c4deszes/bike-front-light/sw/README.md

# Front light software

## Open issues

- ILD8150 Open/Short circuit detection and reporting
- TLD509x control and monitoring
- Temperature monitoring and derating

## Deferred tasks

- Bootloader (depends on SAMC21 support in the Bootloader and HAL library)
- Externally configurable product parameters (depends on diagnostic protocol extension)
