c4deszes/bike-front-light/hw/design/connector-pcb/models/B03B-JWPF-SK-R.STEP

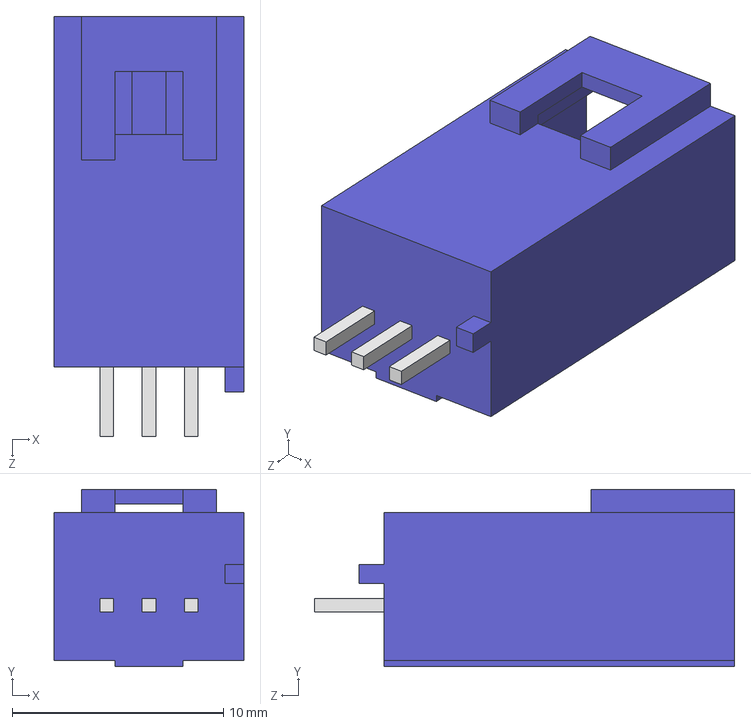
[picture p1: CAD file, 2025-01-21]
hw/design/connector-pcb/models/B03B-JWPF-SK-R.STEP
9.00 x 8.40 x 19.9 mm
