c4deszes/bike-front-light/hw/design/connector-pcb/pcba_outline.dxf

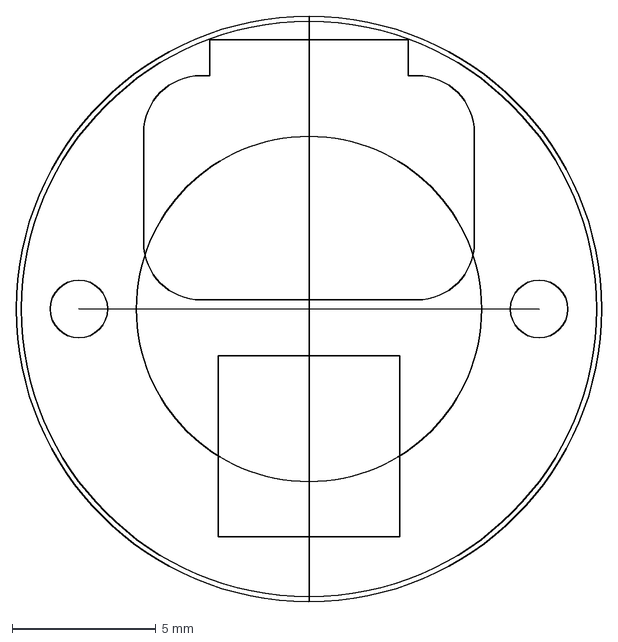
[picture p2: CAD file, 2024-05-25]
hw/design/connector-pcb/pcba_outline.dxf
20.4 x 20.4 mm
