c4deszes/bike-front-light/hw/design/controller_al8891/models/VLS3015CX-1R0M-1.step

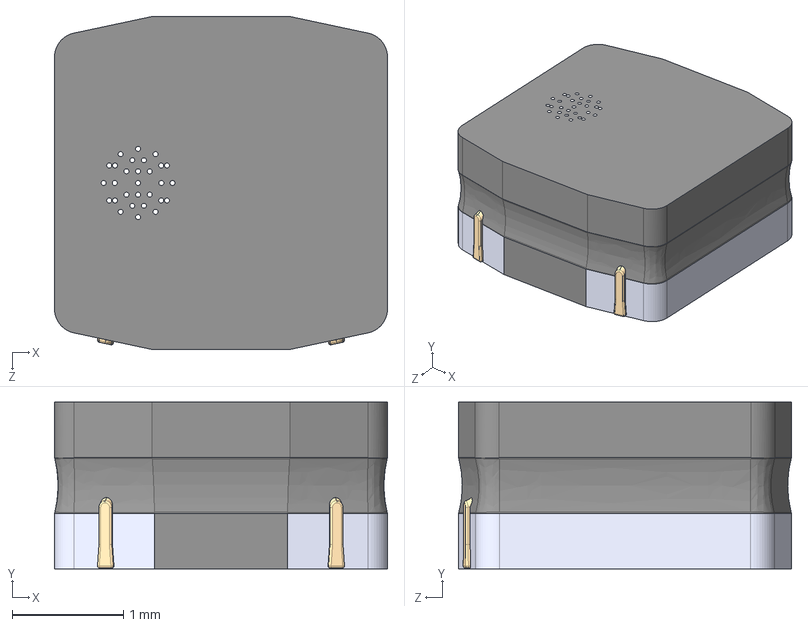
[picture p3: CAD file, 2026-06-22]
hw/design/controller_al8891/models/VLS3015CX-1R0M-1.step
3.00 x 1.50 x 3.00 mm
