c4deszes/bike-front-light/hw/design/controller_al8891/pcba_outline.dxf

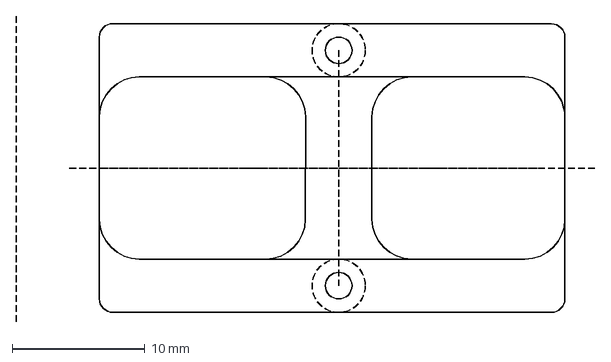
[picture p4: CAD file, 2026-06-22]
hw/design/controller_al8891/pcba_outline.dxf
43.5 x 23.0 mm
