c4deszes/bike-front-light/hw/design/led-pcb/pcba_outline.dxf

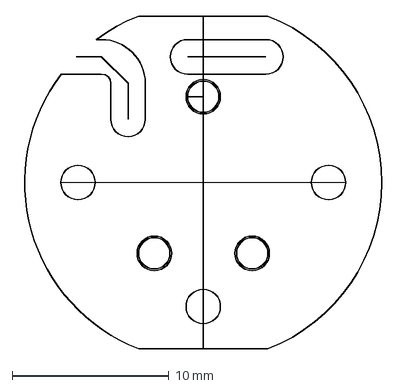
[picture p5: CAD file, 2024-05-25]
hw/design/led-pcb/pcba_outline.dxf
23.3 x 21.3 mm
