c4deszes/bike-front-light/me/gen1.0/Lockring_Pressfit.stl

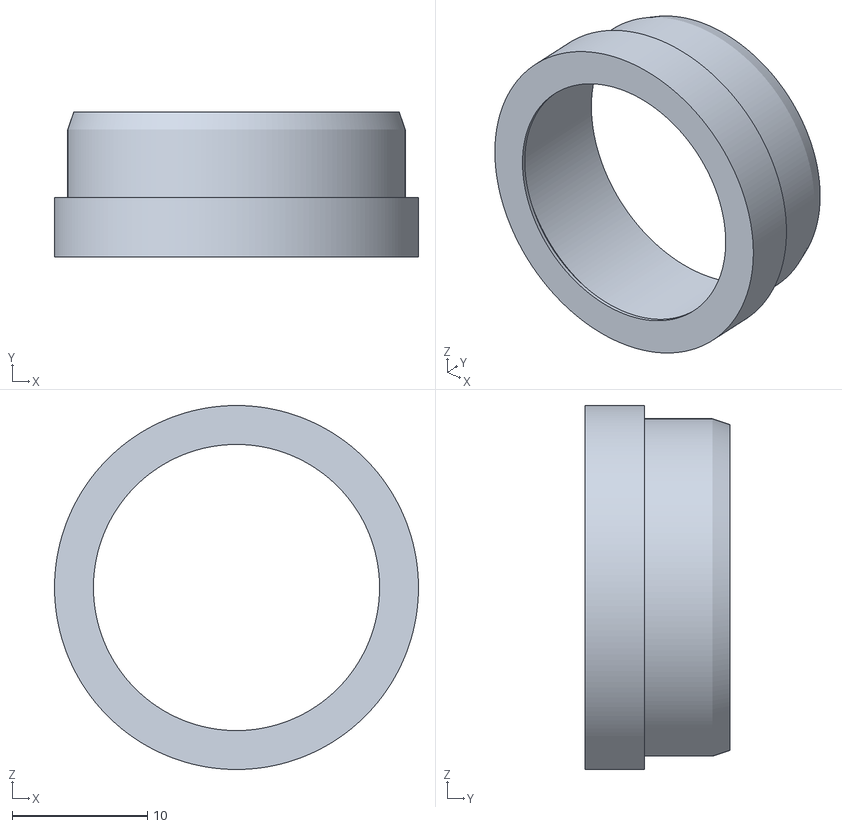
[picture p6: CAD file, 2024-06-23]
me/gen1.0/Lockring_Pressfit.stl
26.9 x 10.7 x 26.9
