c4deszes/bike-front-light/me/gen1.1/ConnectorSeal_v15.stl

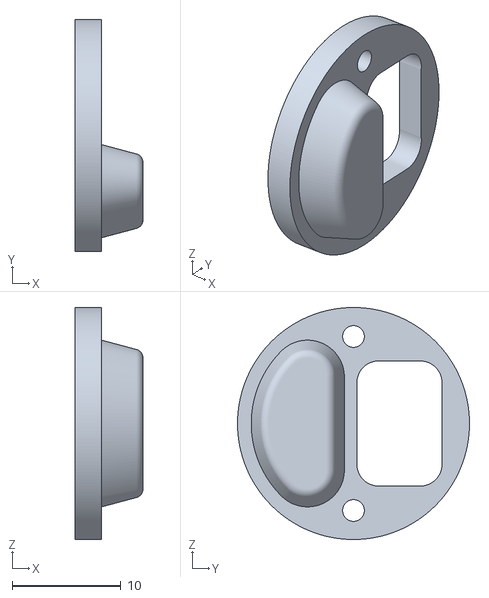
[picture p7: CAD file, 2025-10-22]
me/gen1.1/ConnectorSeal_v15.stl
6.25 x 21.3 x 21.3
