c4deszes/bike-front-light/me/pcba/ConnectorPcb.stl

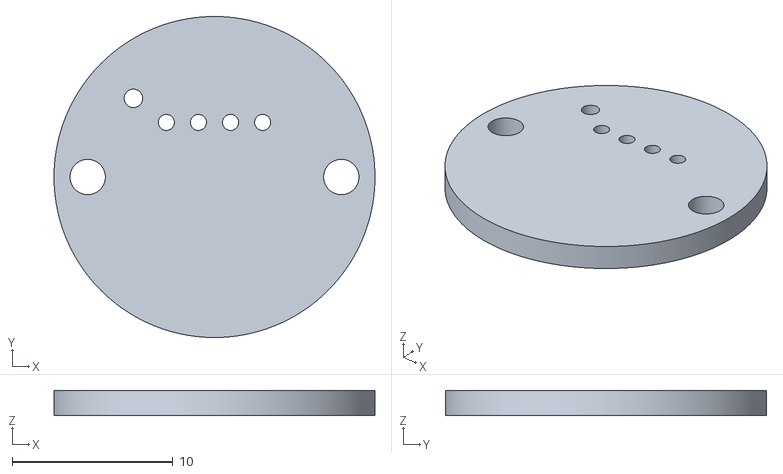
[picture p8: CAD file, 2024-06-23]
me/pcba/ConnectorPcb.stl
20.0 x 20.0 x 1.58
