c4deszes/bike-front-light/hw/design/connector-pcb/models/KSC423G70SHLFG.stp

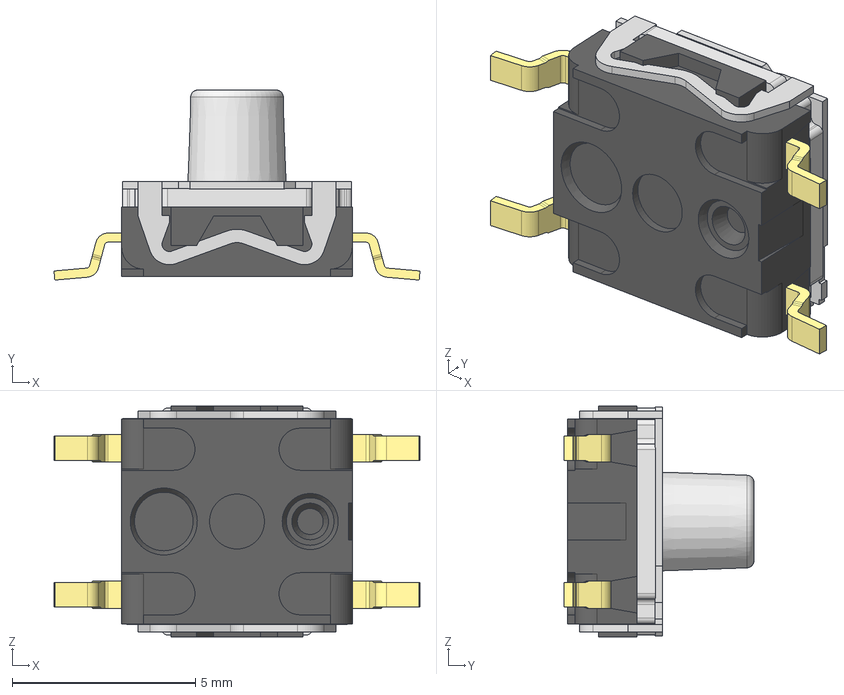
[picture p9: CAD file, 2024-05-25]
hw/design/connector-pcb/models/KSC423G70SHLFG.stp
10.00 x 5.19 x 6.30 mm
KSC4 - body
KSC4 - button
KSC4 - cover
KSC43G_pin x 4
