c4deszes/bike-front-light/hw/design/controller_al8891/models/SIA462DJ-T1-GE3.STEP

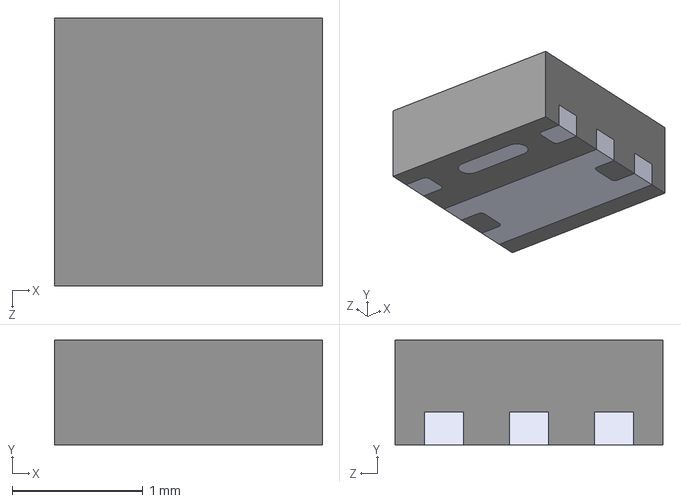
[picture p10: CAD file, 2026-06-22]
hw/design/controller_al8891/models/SIA462DJ-T1-GE3.STEP
2.05 x 0.8 x 2.05 mm
