c4deszes/bike-front-light/me/gen1.0/Cover.stl

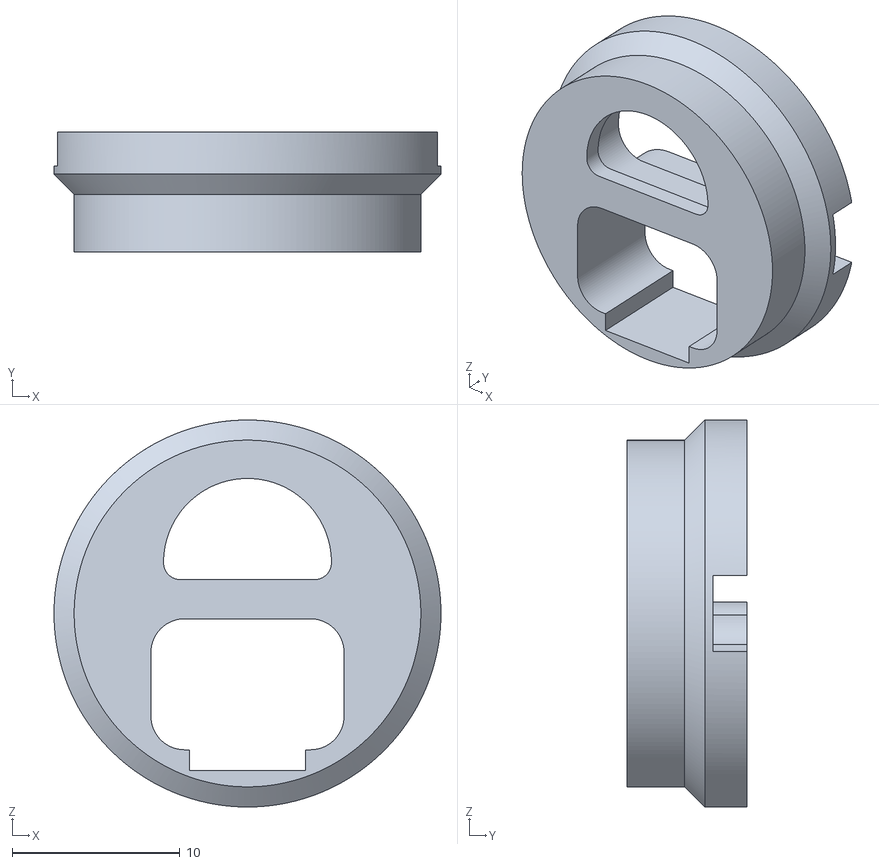
[picture p11: CAD file, 2024-06-23]
me/gen1.0/Cover.stl
23.0 x 7.12 x 23.0
