c4deszes/bike-front-light/me/gen1.1/Connector_Cover_v11.stl

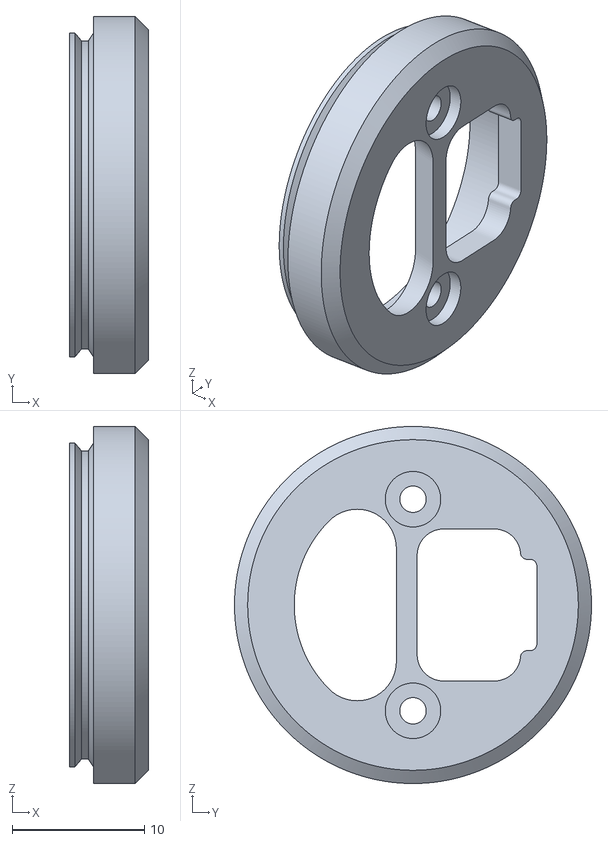
[picture p12: CAD file, 2025-10-22]
me/gen1.1/Connector_Cover_v11.stl
5.95 x 27.0 x 27.0
