c4deszes/bike-front-light/me/pcba/ControlPcb.stl

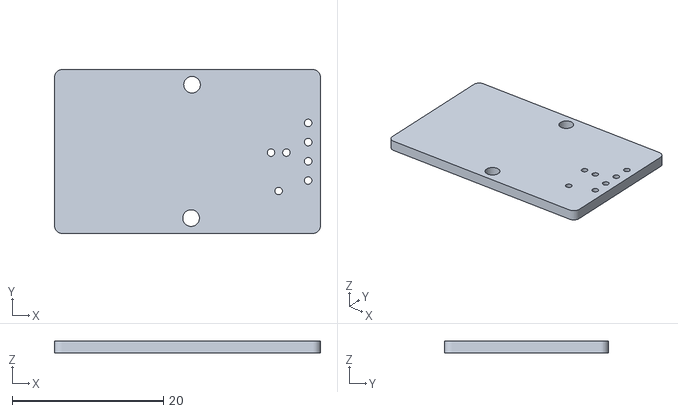
[picture p13: CAD file, 2024-06-23]
me/pcba/ControlPcb.stl
35.2 x 21.7 x 1.58
