c4deszes/bike-front-light/hw/design/controller_al8891/models/ASPI-6045.step

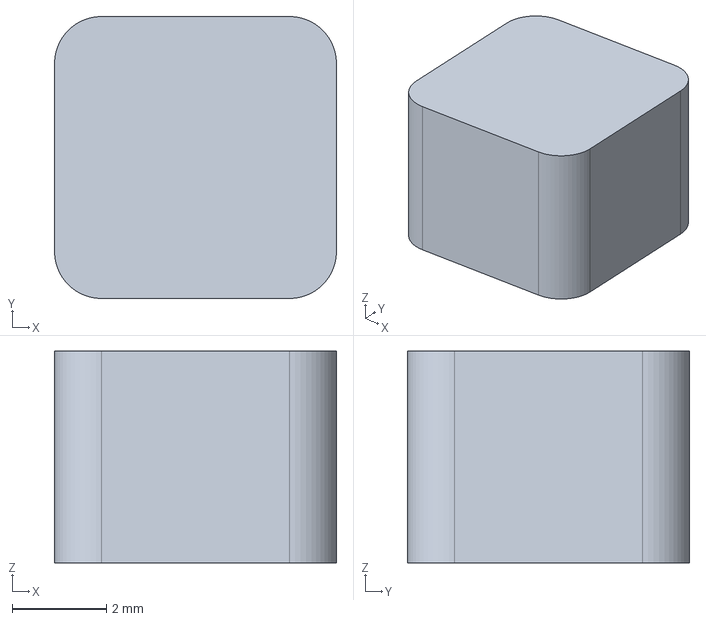
[picture p14: CAD file, 2024-05-25]
hw/design/controller_al8891/models/ASPI-6045.step
6.00 x 6.00 x 4.50 mm
