c4deszes/bike-front-light/me/gen1.0/Carrier.stl

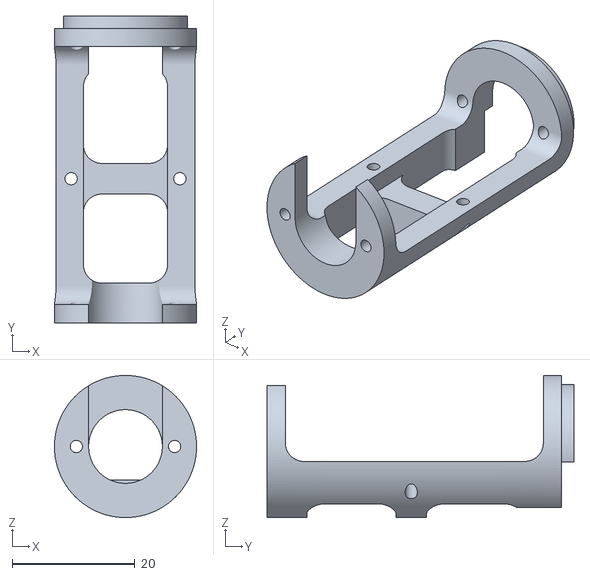
[picture p15: CAD file, 2024-06-23]
me/gen1.0/Carrier.stl
23.1 x 50.0 x 23.1
