c4deszes/bike-front-light/me/gen1.1/Internal_Carrier_v6.stl

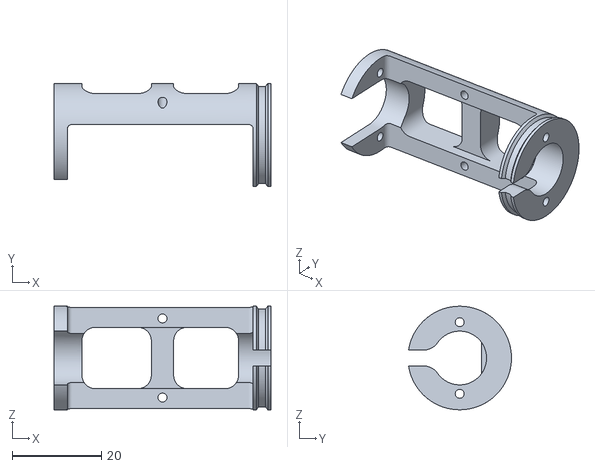
[picture p16: CAD file, 2025-10-22]
me/gen1.1/Internal_Carrier_v6.stl
48.5 x 23.0 x 23.1
