c4deszes/bike-front-light/me/pcba/LedPcb.stl

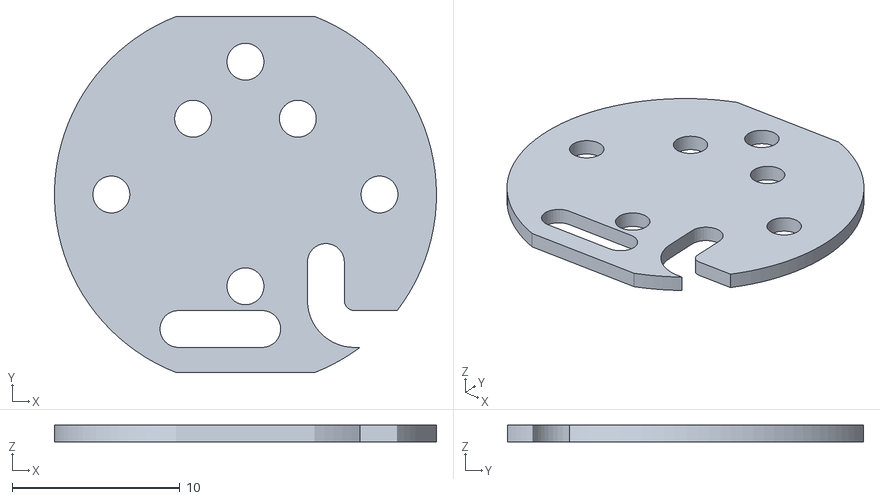
[picture p17: CAD file, 2024-06-23]
me/pcba/LedPcb.stl
22.8 x 21.2 x 0.99
