c4deszes/bike-front-light/me/gen1.0/Button.stl

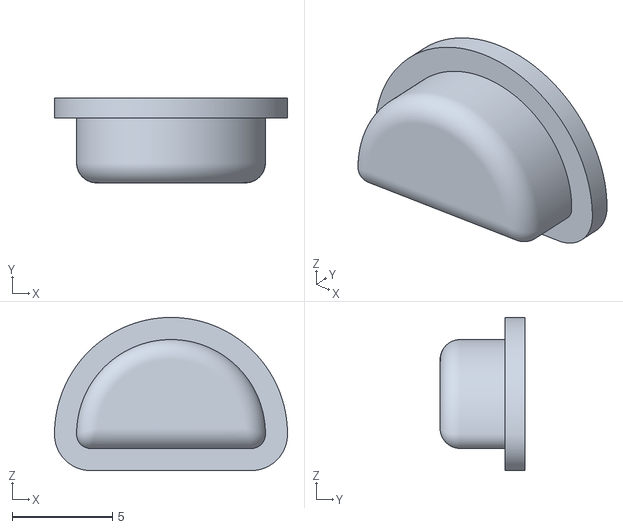
[picture p18: CAD file, 2024-06-23]
me/gen1.0/Button.stl
11.6 x 4.22 x 7.62
