c4deszes/bike-front-light/hw/design/controller_al8891/controller.kicad_pcb

## KiCad design hw/design/controller_al8891/controller.kicad_pcb (2026-06-22)

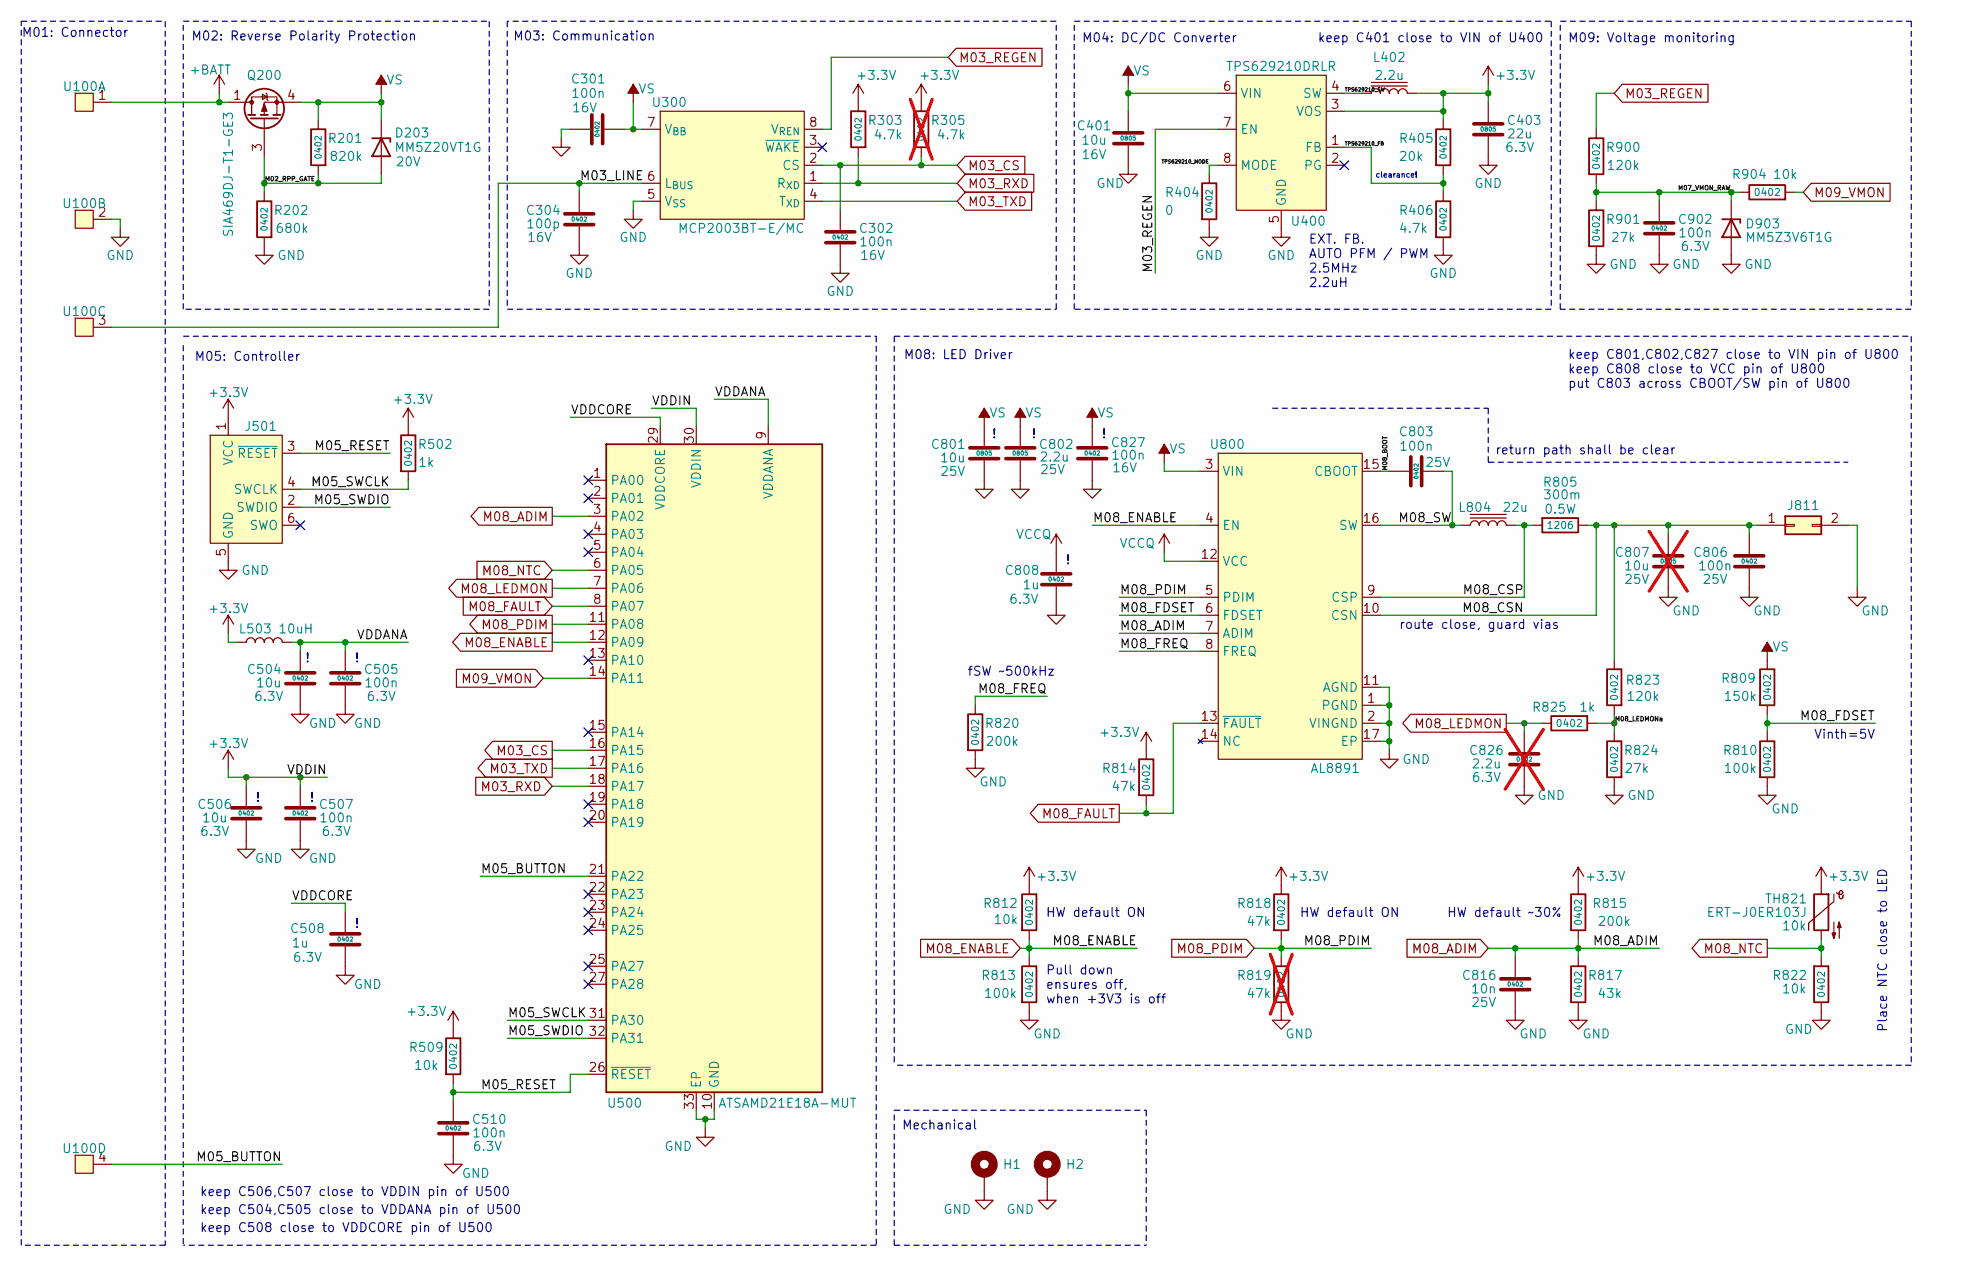
[picture p19: schematic controller.kicad_sch]

Parts:
C301, C302, C827: 100n; C_0402_1005Metric; Rating 16V
C304: 100p; C_0402_1005Metric; Rating 16V
C401: 10u; C_0805_2012Metric; Rating 16V
C403: 22u; C_0805_2012Metric; Rating 6.3V
C504, C506: 10u; C_0402_1005Metric; Rating 6.3V
C505, C507, C510, C902: 100n; C_0402_1005Metric; Rating 6.3V
C508, C808: 1u; C_0402_1005Metric; Rating 6.3V
C801: 10u; C_0805_2012Metric; Rating 25V
C802: 2.2u; C_0805_2012Metric; Rating 25V
C803: 100n; C_0603_1608Metric; Rating 25V
C806: 100n; C_0402_1005Metric; Rating 25V
C807: 10u; C_0805_2012Metric; Rating 25V; not fitted
C816: 10n; C_0402_1005Metric; Rating 25V
C826: 2.2u; C_0402_1005Metric; Rating 6.3V; not fitted
D203: MM5Z20VT1G; D_SOD-523; Rating 20V
D903: MM5Z3V6T1G; D_SOD-523
H1, H2: MountingHole_Pad; MountingHole_2.2mm_M2_DIN965_Pad_TopOnly
J501: Conn_ARM_SWD_TagConnect_TC2030-NL; Tag-Connect_TC2030-IDC-NL_2x03_P1.27mm_Vertical
J811: Conn_02x01; 2pinConnector
L402: 2.2u; L_Coilcraft_LPS3010
L503: 10uH; L_0603_1608Metric
L804: 22u; ASPI-6045
Q200: SIA469DJ-T1-GE3; Vishay_PowerPAK_SC70-6L_Single
R201: 820k; R_0402_1005Metric
R202: 680k; R_0402_1005Metric
R303, R406: 4.7k; R_0402_1005Metric
R305: 4.7k; R_0402_1005Metric; not fitted
R404: 0; R_0402_1005Metric
R405: 20k; R_0402_1005Metric
R502, R825: 1k; R_0402_1005Metric
R509, R812, R822, R904: 10k; R_0402_1005Metric
R805: 300m; R_1206_3216Metric; Rating 0.5W
R809: 150k; R_0402_1005Metric
R810, R813: 100k; R_0402_1005Metric
R814, R818: 47k; R_0402_1005Metric
R815, R820: 200k; R_0402_1005Metric
R817: 43k; R_0402_1005Metric
R819: 47k; R_0402_1005Metric; not fitted
R823, R900: 120k; R_0402_1005Metric
R824, R901: 27k; R_0402_1005Metric
TH821: ERT-J0ER103J; R_0402_1005Metric
U100: PinHeader_1x04_P2.54mm_Vertical
U300: MCP2003BT-E/MC; DFN-8-1EP_3x2mm_P0.5mm_EP1.7x1.4mm
U400: TPS629210DRLR; SOT-583-8
U500: ATSAMD21E18A-MUT; VQFN-32-1EP_5x5mm_P0.5mm_EP3.5x3.5mm
U800: AL8891; TSSOP-16-1EP_4.4x5mm_P0.65mm_EP3x3mm

Connections:
+3.3V: C403.1, C506.2, C507.2, J501.1 (VCC), L402.2, L503.1, R303.1, R305.1, R405.1, R502.1, R509.1, R812.1, R814.1, R815.1, R818.1, TH821.1, U400.3 (VOS), U500.30 (VDDIN)
+BATT: Q200.1 (D), U100.1
/M02_RPP_GATE: D203.2 (A), Q200.3 (G), R201.2, R202.1
/M03_LINE: C304.2, U100.3, U300.6 (L_{BUS})
/M05_BUTTON: U100.4, U500.21 (PA22)
/M05_RESET: C510.2, J501.3 (~RESET), R509.2, U500.26 (~RESET)
/M05_SWCLK: J501.4 (SWCLK), R502.2, U500.31 (PA30)
/M05_SWDIO: J501.2 (SWDIO), U500.32 (PA31)
/M07_VMON_RAW: C902.2, D903.1 (K), R900.2, R901.1, R904.1
/M08_BOOT: C803.1, U800.15 (CBOOT)
/M08_CSN: C806.1, C807.2, J811.1, R805.1, R823.1, U800.10 (CSN)
/M08_CSP: L804.2, R805.2, U800.9 (CSP)
/M08_FDSET: R809.2, R810.1, U800.6 (FDSET)
/M08_FREQ: R820.1, U800.8 (FREQ)
/M08_LEDMONa: R823.2, R824.1, R825.2
/M08_SW: C803.2, L804.1, U800.16 (SW)
/TPS629210_FB: R405.2, R406.1, U400.1 (FB)
/TPS629210_MODE: R404.1, U400.8 (MODE)
/TPS629210_SW: L402.1, U400.4 (SW)
/VDDANA: C504.2, C505.2, L503.2, U500.9 (VDDANA)
/VDDCORE: C508.2, U500.29 (VDDCORE)
GND: C301.1, C302.1, C304.1, C401.1, C403.2, C504.1, C505.1, C506.1, C507.1, C508.1, C510.1, C801.1, C802.1, C806.2, C807.1, C808.1, C816.2, C826.1, C827.1, C902.1, D903.2 (A), H1.1, H2.1, J501.5 (GND), J811.2, R202.2, R404.2, R406.2, R810.2, R813.2, R817.2, R819.2, R820.2, R822.1, R824.2, R901.2, U100.2, U300.5 (V_{SS}), U400.5 (GND), U500.10 (GND), U500.28 (GND), U500.33 (EP), U800.1 (PGND), U800.2 (VINGND), U800.11 (AGND), U800.17 (EP)
M03_CS: C302.2, R305.2, U300.2 (CS), U500.16 (PA15)
M03_REGEN: R900.1, U300.8 (V_{REN}), U400.7 (EN)
M03_RXD: R303.2, U300.1 (R_{XD}), U500.18 (PA17)
M03_TXD: U300.4 (T_{XD}), U500.17 (PA16)
M08_ADIM: C816.1, R815.2, R817.1, U500.3 (PA02), U800.7 (ADIM)
M08_ENABLE: R812.2, R813.1, U500.12 (PA09), U800.4 (EN)
M08_FAULT: R814.2, U500.8 (PA07), U800.13 (~FAULT)
M08_LEDMON: C826.2, R825.1, U500.7 (PA06)
M08_NTC: R822.2, TH821.2, U500.6 (PA05)
M08_PDIM: R818.2, R819.1, U500.11 (PA08), U800.5 (PDIM)
M09_VMON: R904.2, U500.14 (PA11)
VCCQ: C808.2, U800.12 (VCC)
VS: C301.2, C401.2, C801.2, C802.2, C827.2, D203.1 (K), Q200.4 (S), R201.1, R809.1, U300.7 (V_{BB}), U400.6 (VIN), U800.3 (VIN)

Notes on the sheet:
route close, guard vias
Pull down ensures off, when +3V3 is off
M09: Voltage monitoring
M04: DC/DC Converter
EXT. FB. AUTO PFM / PWM 2.5MHz 2.2uH
return path shall be clear
keep C504,C505 close to VDDANA pin of U500
M02: Reverse Polarity Protection
keep C801,C802,C827 close to VIN pin of U800 keep C808 close to VCC pin of U800 put C803 across CBOOT/SW pin of U800
keep C508 close to VDDCORE pin of U500
HW default ON
clearance!
Mechanical
keep C506,C507 close to VDDIN pin of U500
Place NTC close to LED
M05: Controller
M03: Communication
M01: Connector
Vinth=5V
keep C401 close to VIN of U400
HW default ~30%
M08: LED Driver
fSW ~500kHz

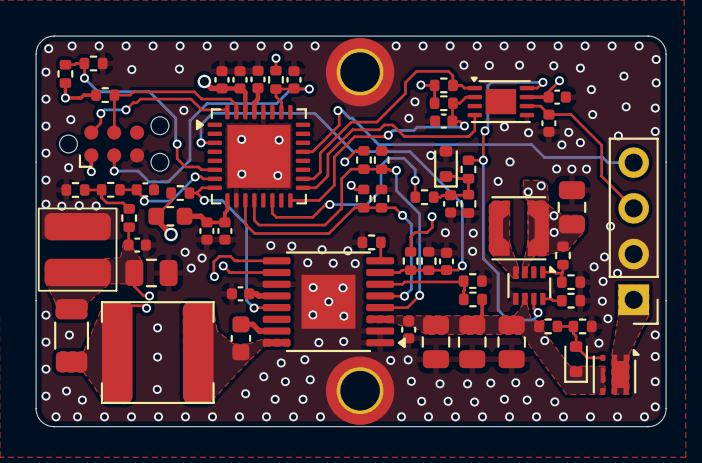
[picture p20: board controller.kicad_pcb from above]

Board: 4 copper layers, 35.0 x 21.7 mm, 64 parts (0 on the bottom side), 35 nets.
