c4deszes/bike-front-light/hw/design/connector-pcb/connector-pcb.kicad_pcb

## KiCad design hw/design/connector-pcb/connector-pcb.kicad_pcb (2025-01-21)

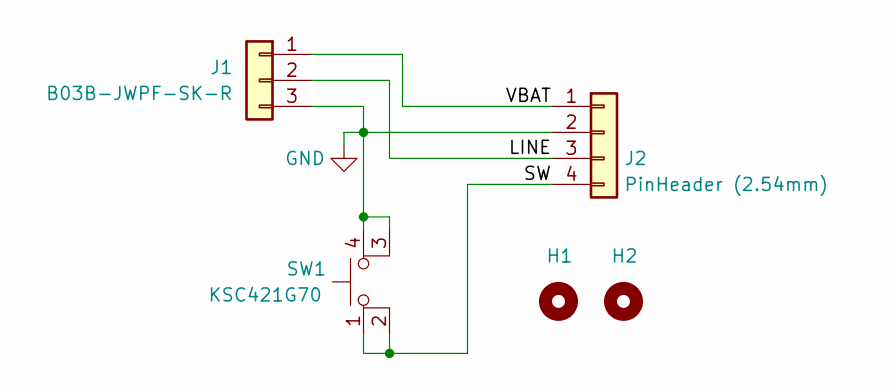
[picture p21: schematic connector-pcb.kicad_sch]

Parts:
H1, H2: MountingHole_Pad; MountingHole_2.2mm_M2_ISO14580
J1: B03B-JWPF-SK-R; JST_JWPF_B03B-JWPF-SK-R_1x03_P2.00mm_Vertical
J2: PinHeader (2.54mm); PinHeader_1x04_P2.00mm_Vertical_SMD_Pin1Left
SW1: KSC421G70; KSC4

Connections:
/LINE: J1.2, J2.3
/SW: J2.4, SW1.1, SW1.2
/VBAT: J1.1, J2.1
GND: J1.3, J2.2, SW1.3 (K), SW1.4 (A)

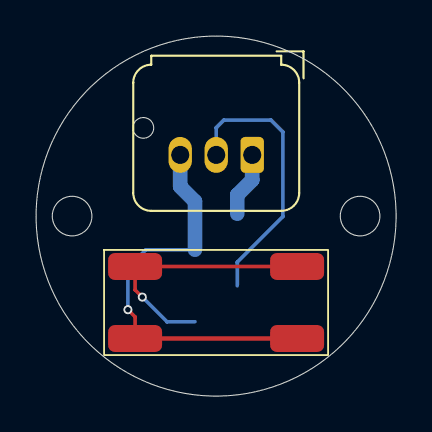
[picture p22: board connector-pcb.kicad_pcb from above]

Board: 2 copper layers, 20.0 x 20.0 mm, 5 parts (1 on the bottom side), 4 nets.
