c4deszes/bike-front-light/sw/src/app/sys_state.c

#include "app/sys_state.h"
#include "common/swtimer.h"
#include "app/config.h"

#include "app/brightness.h"
#include "app/strobe.h"
#include "app/comm.h"

#include "line_api.h"

//#include "bl/api.h"
#include "sam.h"

#include "app/button.h"

typedef enum {
    sys_state_init,         /* When starting up */
    sys_state_normal,       /* When target signal is valid */
    sys_state_safety,       /* When communication issues occur */
    sys_state_goto_boot,    /* When boot entry is requested */
    sys_state_goto_reset,   /* When reset is requested */
    sys_state_goto_sleep    /* When sleep is requested */
} sys_state_t;

static sys_state_t sys_state;
static swtimer_t* sys_transition_timer; 

void SYSSTATE_Init(void) {
    sys_state = sys_state_init;
    sys_transition_timer = SWTIMER_Create();
    SWTIMER_Setup(sys_transition_timer, FEATURE_SYSTEM_TIME_INIT);
}

uint64_t boot_entry_key __attribute__((section(".bl_shared_ram")));
static void SYSSTATE_BootEntry(void) {
    //boot_entry_key = BOOT_ENTRY_MAGIC;

    //NVIC_SystemReset();
}

static void SYSSTATE_Reset(void) {
    // NVIC_SystemReset();
}

void SYSSTATE_Update10ms(void) {
    if (sys_state == sys_state_init && SWTIMER_Elapsed(sys_transition_timer)) {
        if (COMM_LightRequestTimeout()) {
            sys_state = sys_state_safety;
        }
        else {
            sys_state = sys_state_normal;
        }
    }
    else if (sys_state == sys_state_normal) {
        uint8_t light_behavior = COMM_LightBehavior();
        if (light_behavior == LINE_ENCODER_LightBehaviorEncoder_Default) {
            STROBE_SetSource(STROBE_ConvertSource(CONFIG_DEFAULT_STROBE_SOURCE));
        }
        else if (light_behavior == LINE_ENCODER_LightBehaviorEncoder_Blink) {
            STROBE_SetSource(STROBE_ConvertSource(CONFIG_PRIMARY_STROBE_SOURCE));
        }
        else {
            STROBE_SetSource(strobe_source_disabled);
        }

        uint8_t light_mode = COMM_LightMode();
        if (light_mode == LINE_ENCODER_LightModeEncoder_Adaptive) {
            BRIGHTNESS_SetMode(brightness_mode_adaptive);
        }
        else if (light_mode == LINE_ENCODER_LightModeEncoder_Standard) {
            BRIGHTNESS_SetMode(brightness_mode_standard);
        }
        else if (light_mode == LINE_ENCODER_LightModeEncoder_Emergency) {
            BRIGHTNESS_SetMode(brightness_mode_emergency);
        }
        else if (light_mode == LINE_ENCODER_LightModeEncoder_Off) {
            BRIGHTNESS_SetMode(brightness_mode_off);
        }
        else {
            BRIGHTNESS_SetMode(brightness_mode_standard);
        }

        BRIGHTNESS_SetTarget(COMM_GetTargetBrightness());

        if (COMM_LightRequestTimeout() && COMM_LightMode() != LINE_ENCODER_LightModeEncoder_Emergency) {
            /* If the master's last instruction was emergency mode then we don't transition out  */
            sys_state = sys_state_safety;
        }
    }
    else if (sys_state == sys_state_safety) {
        STROBE_SetSource(STROBE_ConvertSource(CONFIG_SAFETY_STROBE_SOURCE));
        BRIGHTNESS_SetMode(brightness_mode_safety);

        if (!COMM_LightRequestTimeout()) {
            sys_state = sys_state_normal;
        }
    }
    // TODO: go to boot state, self reset
}
