c4deszes/bike-front-light/sw/src/app/strobe.c

#include "app/strobe.h"
#include "app/brightness.h"

#include "common/swtimer.h"

#include "app/config.h"

#include <stdbool.h>

static strobe_source_t strobe_source;
static swtimer_t* strobe_internal_timer;
static bool strobe_internal_flag;

void STROBE_Init(void) {
    strobe_internal_flag = false;
    strobe_source = strobe_source_disabled;
    strobe_internal_timer = SWTIMER_Create();
    SWTIMER_Setup(strobe_internal_timer, CONFIG_BRIGHTNESS_STROBE_SINGLE_OFF_TIME);
}

void STROBE_SetSource(strobe_source_t source) {
    strobe_source = source;
}

strobe_source_t STROBE_ConvertSource(uint8_t config) {
    if (config == CONFIG_STROBE_SOURCE_DISABLED) {
        return strobe_source_disabled;
    }
    else if (config == CONFIG_STROBE_SOURCE_INTERNAL_SINGLE) {
        return strobe_source_internal_single;
    }
    // TODO: support for negative and positive
    return strobe_source_disabled;
}

void STROBE_Update1ms(void) {
    if (strobe_source == strobe_source_disabled) {
        /* In case the source is disabled blinking should also be disabled */
        BRIGHTNESS_Strobe(true);
    }
    else if (strobe_source == strobe_source_internal_single) {
        if (SWTIMER_Elapsed(strobe_internal_timer)) {
            strobe_internal_flag = !strobe_internal_flag;
            if (strobe_internal_flag) {
                SWTIMER_Setup(strobe_internal_timer, CONFIG_BRIGHTNESS_STROBE_SINGLE_ON_TIME);
            }
            else {
                SWTIMER_Setup(strobe_internal_timer, CONFIG_BRIGHTNESS_STROBE_SINGLE_OFF_TIME);
            }
            BRIGHTNESS_Strobe(strobe_internal_flag);
        }
    }
    // TODO: support for external positive and negative sources
    // TODO: in all cases the LEDs shall never be off for more than 1.5seconds
    //       if that's the case the strobe shall self disable and set an error flag
    else {
        /* Same as disabled */
        BRIGHTNESS_Strobe(true);
    }
}
