c4deszes/bike-front-light/(commit log)

2024-05-25 Initial hardware design
    [ASPI-6045.step, B04B-JWPF-SK-R.step, KSC423G70SHLFG.stp, SST-12-WxS.step, connector-pcb.kicad_pcb, connector-pcb.kicad_sch, controller.kicad_pcb, controller.kicad_sch]
2024-05-28 Final hardware design
    [ASPI-6045.step, connector-pcb.kicad_pcb, controller.kicad_pcb, controller.kicad_sch, led-pcb.kicad_pcb, pcba_outline.dxf]
2024-06-09 Initial software
    [board.cfg]
2024-06-11 Temperature monitoring (not working)
    [board.c, button.c, comm.c, config.h, init.c, led_driver_ild8150.c, tasks.c, tmon.c]
2024-06-22 Hardware schematic cleanup
    [connector-pcb.kicad_pcb, connector-pcb.kicad_sch, controller.kicad_pcb, controller.kicad_sch]
2024-06-22 Button controlled software
2024-06-23 Mechanical model
    [Button.stl, Carrier.stl, ConnectorPcb.stl, ControlPcb.stl, Cover.stl, LedPcb.stl, Lockring_Pressfit.stl]
2024-08-13 Working remote control and button feedback
2024-08-14 Fixed temperature measurement
2024-08-15 ILD8150 voltage monitoring (not working)
    [comm.c, config.h, led_driver_ild8150.c]
2025-01-21 New software parameters
    [board.cfg]
2025-01-21 Connector board modified to use the 3pin connector
    [B03B-JWPF-SK-R.STEP, B04B-JWPF-SK-R.step, connector-pcb.kicad_pcb, connector-pcb.kicad_sch]
2025-10-22 Flash script
    [flash.cfg]
2025-10-22 Gen1.1 mechanical design
    Reduces number of parts, instead of pressfit ring it's
    an oring seal that keeps the assembly inside the case.
    The new button cover should provide better ingress
    protection.
    The new internal carrier is slightly shorter and has an
    oring to seal some of the electronics.
    [Button.stl, Carrier.stl, ConnectorSeal_v15.stl, Connector_Cover_v11.stl, Cover.stl, Internal_Carrier_v6.stl, Lockring_Pressfit.stl]
2026-05-10 Complete Gen1.1 based on AL8891
    [ASPI-6045.step, SIA462DJ-T1-GE3.STEP, VLS3015CX-1R0M-1.step, controller.kicad_pcb, controller.kicad_sch, pcba_outline.dxf]
2026-05-21 Finalized design (JLC ordered)
    [controller.kicad_pcb, controller.kicad_sch]
