c4deszes/bike-front-light/(notices)

Notices in the files:
hw/design/connector-pcb/models/KSC423G70SHLFG.stp:
author */ ('License CC BY-ND 4.0'),
